84566635/RunnerMachine/README.md

# RunnerMachine
****
## RunnerMachine Project
* This prohject is for smart gyms!!! This project is running in a stc microcomputer platform includeing Relay,**WIFI** module **RFID reader** and so on.
## Function:
* This project can get the user's id infroamtion using the rfid model,and can get the data which is about runner machine like the speed, the height, the rate of heart and so on.
* This data will be transmit via the wifi interface which can be the received by the wifi router. We can use the rfid card info to manage users.
