84566635/RunnerMachine/跑步机项目资料集/RFID刷卡控制流程图v1.pdf

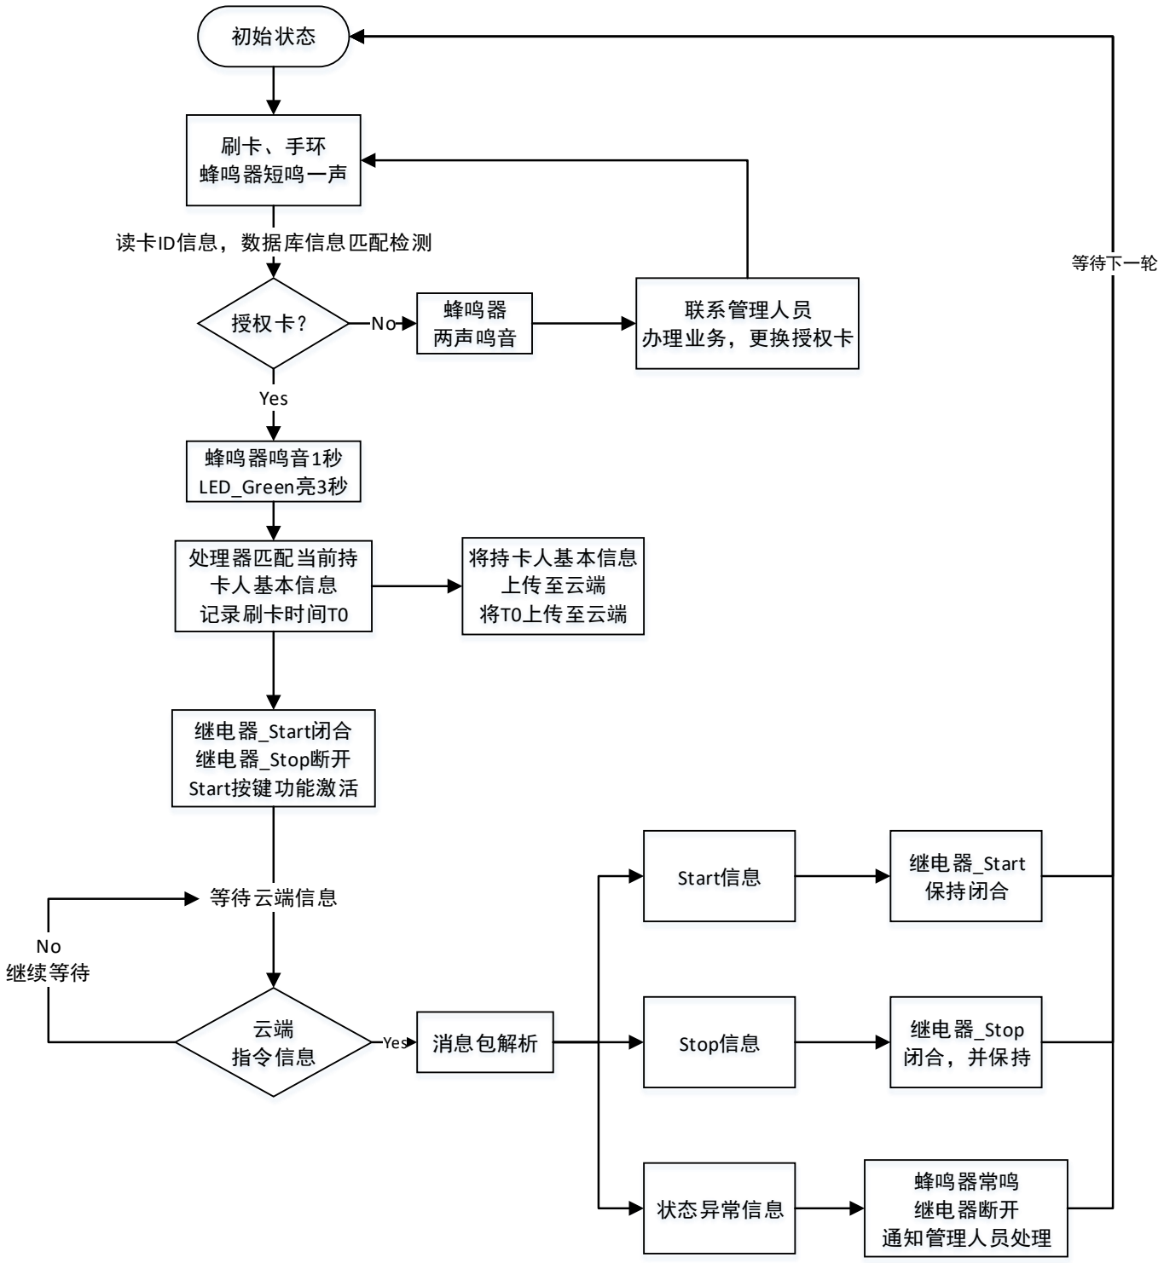
[picture p1: figure]
初始状态; 刷卡、手环 蜂鸣器短鸣一声; 读卡ID信息，数据库信息匹配检测; 授权卡？; 联系管理人员 办理业务，更换授权卡; Yes; 处理器匹配当前持 卡人基本信息 记录刷卡时间T0; 继电器_Start闭合 继电器_Stop断开 Start按键功能激活; 蜂鸣器 两声鸣音; 蜂鸣器鸣音1秒 LED_Green亮3秒; 云端 指令信息; 等待云端信息; No 继续等待; 消息包解析; 将持卡人基本信息 上传至云端 将T0上传至云端; Stop信息; Start信息; 状态异常信息; 继电器_Start 保持闭合; 继电器_Stop 闭合，并保持; 蜂鸣器常鸣 继电器断开 通知管理人员处理; 等待下一轮
