84566635/RunnerMachine/RFID_PCB/电路板/stc15xx-sch-pcb-library/stcmcu_Altium142_IntLib/Readme.txt

    本压缩包有3个文件，除了readme.txt文件以外，其余是altium的库文件，包含了stc公司的stc15系列所有单片机的电路图符号库和PCB的封装库。
库文件是用Altium designer 14.2.4版制作的，如果用低版本的altium软件，如protel 99, 请下载protel99版本并导入，或者请与STC公司联系获取技术支持。

需要特别注意的是：

		本库文件中的所有封装和元件都没有经过实际应用的验证，尽管有很多客户在用，而且目前也没有收到任何问题报告。但我们强烈建议客户自己再仔细校对一遍。
		STC公司从来没有用这个库文件设计电路图，也没有用它设计板子进行实际验证。
		如果客户因使用本文件而造成任何损失，STC公司不承担任何责任。

技术支持QQ：800003751
