84566635/RunnerMachine/RFIDIntegrated/V1.0/版本说明.txt

2018.01.05编写日志：
      这个版本旨在将RFID、E2PROM、串口功能集合在一起。
功能：
       1、RFID读ID卡号，并将读到的ID卡号串口打印；
       2、将读到的ID卡号写入E2PROM中，写入成功后，进行状态提示；
