84566635/RunnerMachine/跑步机项目资料集/WIFI模块设置参数.docx

网络名称：sports 加密方式：WPA2_AES 密钥:sports123 远端IP：192.168.0.10 端口9090

跑步机自东向西依次是1-16号

16 ip:192.168.0.116 mac:28:F3:66:43:5B:9B 9090

15 ip:192.168.0.115 mac:28:F3:66:44:5A:9E 9090

14 ip:192.168.0.114 mac:28:F3:66:44:59:C1 9090

13 ip:192.168.0.113 mac:40:D6:3C:04:05:2D 9090

12 ip:192.168.0.112 mac:28:F3:66:44:5B:39 9090

11 ip:192.168.0.111 mac:28:F3:66:44:5B:1F 9090

10 ip:192.168.0.110 mac:28:F3:66:44:59:D9 9090

9 ip:192.168.0.109 mac:28:F3:66:44:5A:2D 9090

8 ip:192.168.0.108 mac:28:F3:66:44:5A:90 9090

7 ip:192.168.0.107 mac:28:F3:66:05:87:E4 9090

6 ip:192.106.0.106 mac:28:F3:66:44:5A:8D 9090

5 ip:192.168.0.105 mac:28:F3:66:44:58:A4 9090

4 ip:192.168.0.104 mac:28:F3:66:44:5C:51 9090

3 ip:192.168.0.103 mac:28:F3:66:44:5A:6E 9090

2 ip:192.168.0.102 mac:28:F3:66:44:5B:97 9090

1 ip:192.168.0.101 mac:28:F3:66:44:5A:7C 9090
