84566635/RunnerMachine/跑步机项目资料集/跑步机上行数据协议.docx

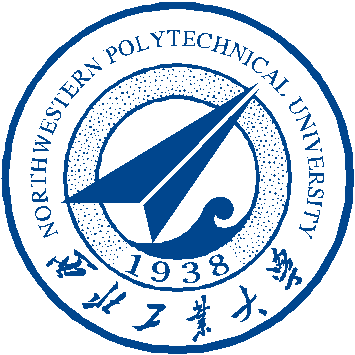
[picture p2: figure]
xb

健身房智能管理项目

资料集

西北工业大学新校区健身房

跑步机平台资料集

# 一、跑步机上行数据通讯协议

跑步机上行数据共计两种格式：

## 1、跑步机使用者的手环卡号信息：

含10字节，单帧发送，刷一次卡成功后，发送该数据，该数据包含：帧头+卡类型+卡ID号+帧尾，不含校验，采用16进制格式发送，波特率为115200，且此卡信息在刷卡成功匹配之后，发送一次。之后，当数据稳定之后，学生ID信息包含跑步机ID信息会以第六帧的形式重新发送，详见第六帧图表。ID信息数据格式具体如表1所示：

表1：使用者ID信息

帧头1 | 帧头2 | 命令3 | 卡类型 4-5 | | 卡号 6-9 | | | | 帧尾10
aaH | 55H | 06H | 44H | 00H | xxH | xxH | xxH | xxH | ccH

## 2、跑步机运行状态信息：

该运动状态信息包含6帧数据，共计120字节数据，每帧数据采用20个字节，未使用的字节数据填0，其中第一、第二帧数据传送跑步机设备编号（如图1所示），第三、第四、第五帧传送运动数据，第六帧传送学生ID信息和跑步机ID信息。采用16进制格式发送数据，波特率为115200，且发送周期为1s（平均），跑步机利用WIFI模块一次传送六帧数据，这六帧信息的详细情况如表二、，如下表2、3、4、5、6所示：

1） 第一帧,第二帧：传送设备编号

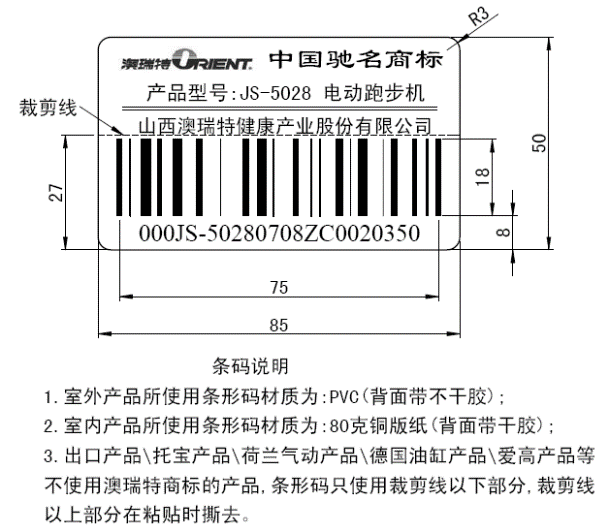
[picture p3: figure]

表2：传送设备编号（帧1,2）

帧头1 | 帧头2 | 命令3 | 第2个字节到第19个字节 | | | | | | | | | | | | | | | | 校验位
aaH | 55H | 01H | 0 | 0 | 0 | J | S | - | 5 | 0 | 2 | 8
aaH | 55H | 02H | 0 | 7 | 0 | 8 | Z | C | 0 | 0 | 2 | 0

图1 跑步机条码说明

2）第三帧、第四帧、第五帧：传送运动数据，运动数据在20字节中的长度如下表3、4、5所示，一个或者两个字节对应一个运动数据，具体长度由运动数据范围确定，比如体重0-150kg，一个字节足够，热量0-10000千卡就需要两个字节，不存在的参数数据用0填充。

表3：运动数据一（帧3）

帧头1 | 帧头2 | 命令3 | 4-19字节 | | | | | | | | | | | | | | | | 校验位
aaH | 55H | 03H | 时间（秒） | | 里程（米） | | 热量 （卡路里） | | 心率 | 转速 （RPM） | 速度 （X10） | | 坡度 N% | 档位 | 功率 （W） | | 力矩 （牛/米）
| | | 高位 | 低位 | 高位 | 低位 | 高 | 低 | | | 高 | 低 | | 1-30 | 高 | 低 | 高 | 低

表4：运动数据二（帧4）

帧头1 | 帧头2 | 命令3 | 4-19字节 | | | | | | | | | | | | | | | | 校验位
aaH | 55H | 04H | 模式 | 负荷 | | 频率 | 次数 | | 组数 | 目标 心率 | 最大肌力 （公斤） | | 最大摄氧量
| | | 1-30 | 高 | 低 | 0-255 | 高 | 低 | | | 高 | 低 | 高 | 低

表5：运动数据三（帧5）

帧头1 | 帧头2 | 命令3 | 备用帧4-19字节 | | | | | | | | | | | | | | | | 校验位
aaH | 55H | 05H

注：

（1）接收数据300，实际速度30。速度有小数点；

（2）坡度同速度，最大155(15.5%)；

（3）负荷也有小数点；

（4）最大摄氧量有小数点；

（5）校验方式：自包括第1位（帧头）到第18位外加两个字节秘钥的按位异或，秘钥暂定为0XE1，0XE2。

3）第六帧：传送学生ID信息和跑步机ID信息，共计20字节数据，其中学生ID信息位于第6-第9位，共计4byte，学生ID信息同跑步机ID信息中间以2byte的字符“cc cc”分割，跑步机ID号信息为第12-第18位共计7byte，其中以16进制形式表示，详见第三节跑步机ID表；帧尾为“ff ff”，共计2byte，详情请看下表6：

表6：ID信息（帧6）

帧头1 | 帧头2 | 命令3 | 卡ID信息(第4-9) | | | | | | 第10-11字节 | | 跑步机ID(第12-18字节) | | | | | | | 19-20字节
aaH | 55H | 06H | 卡类型 | | 卡ID号 | | | | 分隔符 | | 跑步机ID | | | | | | | 帧尾
| | | 44 | 00 | | | | | cc | cc | | | | | | | | ff | ff

# 二、跑步机WIFI接口设置

## 1、路由器无线网络接口：

网络名称：sports；

加密方式：WPA2_AES；

密钥：sports123

## 2、服务器接口设置：

（远端）IP：192.168.0.10

端口：9090

## 3、跑步机WIFI接口：

### 1）接口配置：

工作模式：STA Manual；

网络协议：TCP客户端；

无线参数：需同路由器设置一致；

本地端口：9090；

网络参数：

未启用DHCP；

本地IP：如表1所示：

子网掩码：255.255.255.0；

网关：192.168.0.1；

DNS：192.168.0.1。

串口参数：

波特率：115200；

数据为8位；

检验位：无；

停止位：1位。

### 2）16台跑步机IP地址:

表1：16台跑步机WIFI接口信息

| 编号 | IP地址 | MAC地址 | 端口
东 <-------------------------------> 西 | 16 | 192.168.0.116 | 28:F3:66:43:5B:9B | 9090
| 15 | 192.168.0.115 | 28:F3:66:44:5A:9E | 9090
| 14 | 192.168.0.114 | 28:F3:66:44:59:C1 | 9090
| 13 | 192.168.0.113 | 40:D6:3C:04:05:2D | 9090
| 12 | 192.168.0.112 | 28:F3:66:44:5B:39 | 9090
| 11 | 192.168.0.111 | 28:F3:66:44:5B:1F | 9090
| 10 | 192.168.0.110 | 28:F3:66:44:59:D9 | 9090
| 9 | 192.168.0.109 | 28:F3:66:44:5A:2D | 9090
| 8 | 192.168.0.108 | 28:F3:66:44:5A:90 | 9090
| 7 | 192.168.0.107 | 28:F3:66:05:87:E4 | 9090
| 6 | 192.168.0.106 | 28:F3:66:44:5A:8D | 9090
| 5 | 192.168.0.105 | 28:F3:66:44:58:A4 | 9090
| 4 | 192.168.0.104 | 28:F3:66:44:5C:51 | 9090
| 3 | 192.168.0.103 | 28:F3:66:44:5A:6E | 9090
| 2 | 192.168.0.102 | 28:F3:66:44:5B:97 | 9090
| 1 | 192.168.0.101 | 28:F3:66:44:5A:7C | 9090

# 三、跑步机ID号

表1：16台跑步机ID信息(16进制)

| 跑步机号 | 跑步机ID号(hex)
东 <-------------------------------> 西 | 01 | f628838e1d3600
| 02 | f62883881d30dd
| 03 | f628837f1d2399
| 04 | f62883811d2977
| 05 | f62883a31e4d20
| 06 | f628837a1d1937
| 07 | f62883ae1e58b2
| 08 | f628837a1d1935
| 09 | f62883881d30da
| 10 | f62883a31e4d1e
| 11 | f628837f1d2351
| 12 | f62883cc1f7378
| 13 | f62883b71e5a1e
| 14 | f628837f1d239c
| 15 | f62883971d3783
| 16 | f62883cc1f733d

# 四、手环ID表

共计300个手环，下表为该300个手环的10位ID和8位ID（16进制，程序中使用）

编号 | 10位ID号 | 8位ID号 | | 编号 | 10位ID号 | 8位ID号 | | 编号 | 10位ID号 | 8位ID号
1 | 2317825796 | 0x8A273704 | | 101 | 2318391812 | 0x8A2FDA04 | | 201 | 2318225412 | 0x8A2D5004
2 | 2319273988 | 0x8A3D5004 | | 102 | 2318166532 | 0x8A2C6A04 | | 202 | 2318376452 | 0x8A2F9E04
3 | 2318366724 | 0x8A2F7804 | | 103 | 2318234628 | 0x8A2D7404 | | 203 | 2317765124 | 0x8A264A04
4 | 2317816580 | 0x8A271304 | | 104 | 2318298116 | 0x8A2E6C04 | | 204 | 2318244868 | 0x8A2D9C04
5 | 2318172164 | 0x8A2C8004 | | 105 | 2319257348 | 0x8A3D0F04 | | 205 | 2319354884 | 0x8A3E8C04
6 | 2319336964 | 0x8A3E4604 | | 106 | 2318102020 | 0x8A2B6E04 | | 206 | 2318246148 | 0x8A2DA104
7 | 2318117892 | 0x8A2BAC04 | | 107 | 2318356228 | 0x8A2F4F04 | | 207 | 2319302404 | 0x8A3DBF04
8 | 2318233860 | 0x8A2D7104 | | 108 | 2317758980 | 0x8A263204 | | 208 | 2318387972 | 0x8A2FCB04
9 | 2319296516 | 0x8A3DA804 | | 109 | 2318230788 | 0x8A2D6504 | | 209 | 2318116100 | 0x8A2BA504
10 | 2319282180 | 0x8A3D7004 | | 110 | 2317825540 | 0x8A273604 | | 210 | 2318287364 | 0x8A2E4204
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
98 | 2319409156 | 0x8A3F6004 | | 198 | 2318385156 | 0x8A2FC004 | | 298 | 2318290948 | 0x8A2E5004
99 | 2317860100 | 0x8A27BD04 | | 199 | 2317764356 | 0x8A264704 | | 299 | 2318364164 | 0x8A2F6E04
100 | 2318371844 | 0x8A2F8C04 | | 200 | 2317817860 | 0x8A271804 | | 300 | 2318106884 | 0x8A2B8104
