84566635/RunnerMachine/跑步机项目资料集/刷卡流程V2.pdf

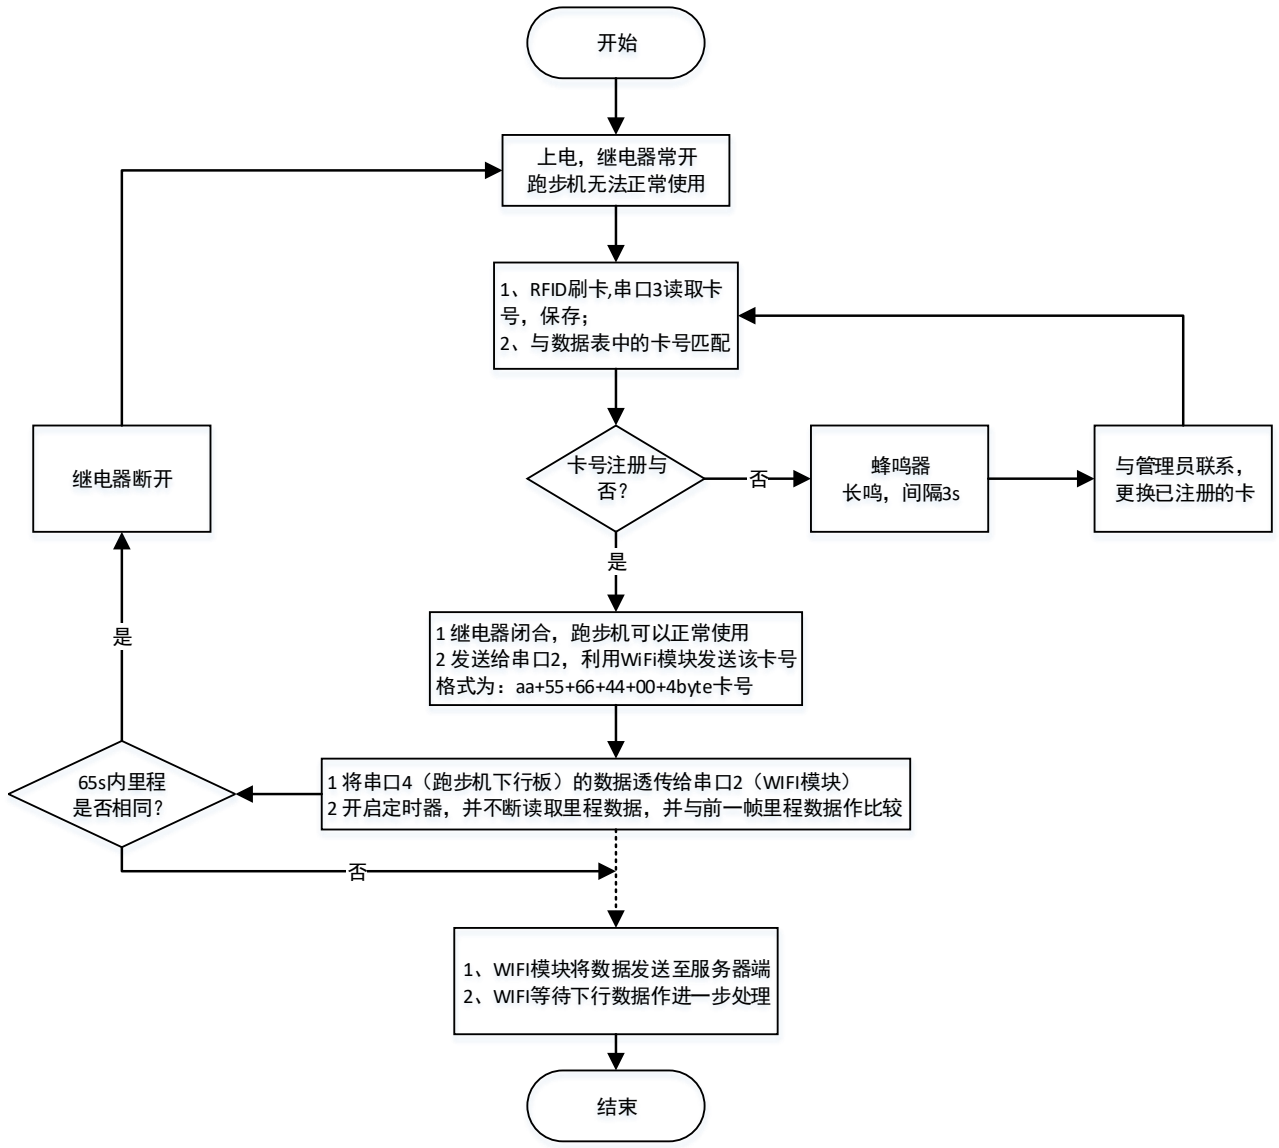
[picture p4: figure]
上电，继电器常开 跑步机无法正常使用; 1、RFID刷卡,串口3读取卡 号，保存； 2、与数据表中的卡号匹配; 卡号注册与 否？; 蜂鸣器 长鸣，间隔3s; 1 继电器闭合，跑步机可以正常使用 2 发送给串口2，利用WiFi模块发送该卡号 格式为：aa+55+66+44+00+4byte卡号; 与管理员联系， 更换已注册的卡; 1 将串口4（跑步机下行板）的数据透传给串口2（WIFI模块） 2 开启定时器，并不断读取里程数据，并与前一帧里程数据作比较; 65s内里程 是否相同？; 继电器断开; 1、WIFI模块将数据发送至服务器端 2、WIFI等待下行数据作进一步处理
