84566635/RunnerMachine/跑步机项目资料集/跑步机项目系统框图.png

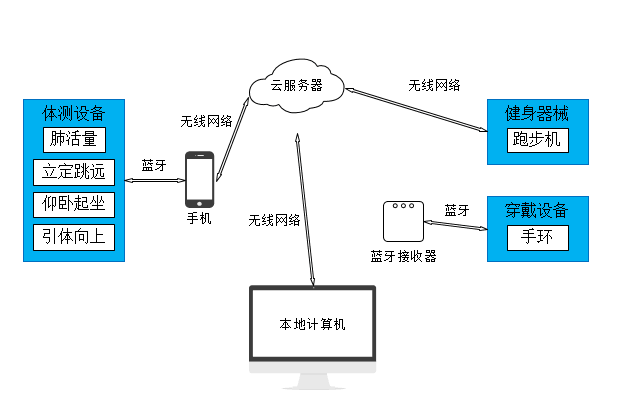
跑步机项目资料集/跑步机项目系统框图.png
