84566635/RunnerMachine/RFID_PCB/电路板/StartV2/跑步机start/StartV2元器件清单.pdf

Bill of Materials | Bill of Materials For PCB Document [StartV2.PcbDoc]
Source Data From: | StartV2.PcbDoc
Project: | | PCB_Project1.PrjPCB
Variant: | | None
Creation Date: 2018/1/22 | 10:21:49
Print Date: | 43122 | 43122.43234
Footprint | Comment | LibRef | Designator | Description | Quantity
BEEP | BEEP | BEEP | BEEP2 | 1
CAP | 104 | CAP | C1, C4, C11 | 3
capc | 10uF | CAPC | C2 | 1
CAP | 105 | CAP | C3, C5 | 2
CAP | 223 | CAP | C6 | 1
CapE | 104 | CapE | C7, C8, C9, C10 | 4
DB9 | RS232 | RS232 | COMP | 1
ConTerminal | ConTerminal | ConTerminal | CT1, CT2, CT3 | 3
D4148_1206 | D4148 | D4148_1206 | D1, D2 | 2
LED_3mm | LED_3mm | LED_3mm | LED1, LED2, LED3, LED4 | 4
mUSB | mUSB | mUSB | mUSB1 | 1
pin4 | pin4 | pin4 | P1 | 1
pin5 | pin5 | pin5 | P2, P3 | 2
pin8 | pin8 | pin8 | P4 | 1
WiFi | WiFi | WiFi | P5 | 1
res | 200 | RES | R1 | 1
res | 1k | RES | R2 | 1
res | 4.7k | RES | R3, R6 | 2
res | 100 | RES | R4, R7 | 2
继电器-SRD | 继电器-Stop | 继电器-SRD | Relay2 | 1
继电器-SRD | 继电器-Start | 继电器-SRD | Rely1 | 1
Horizontal_S
witch

Horizontal_Swit
ch

Horizontal_Swit
ch
S1 | 1
PNP | 8550 | PNP | T1, T2 | 2
STC8A8K64
S4A12_LQF
P64S

STC8A8K64S4A
12_LQFP64

STC8A8K64S4A
12_LQFP64
U2 | 1
RT9193-33 | RT9193-33 | RT9193-33 | U3 | 1
MAX232 | MAX232 | MAX232 | U4 | 1
| | | | 42
Approved | | Notes
