84566635/RunnerMachine/跑步机项目资料集/StartV2.PDF

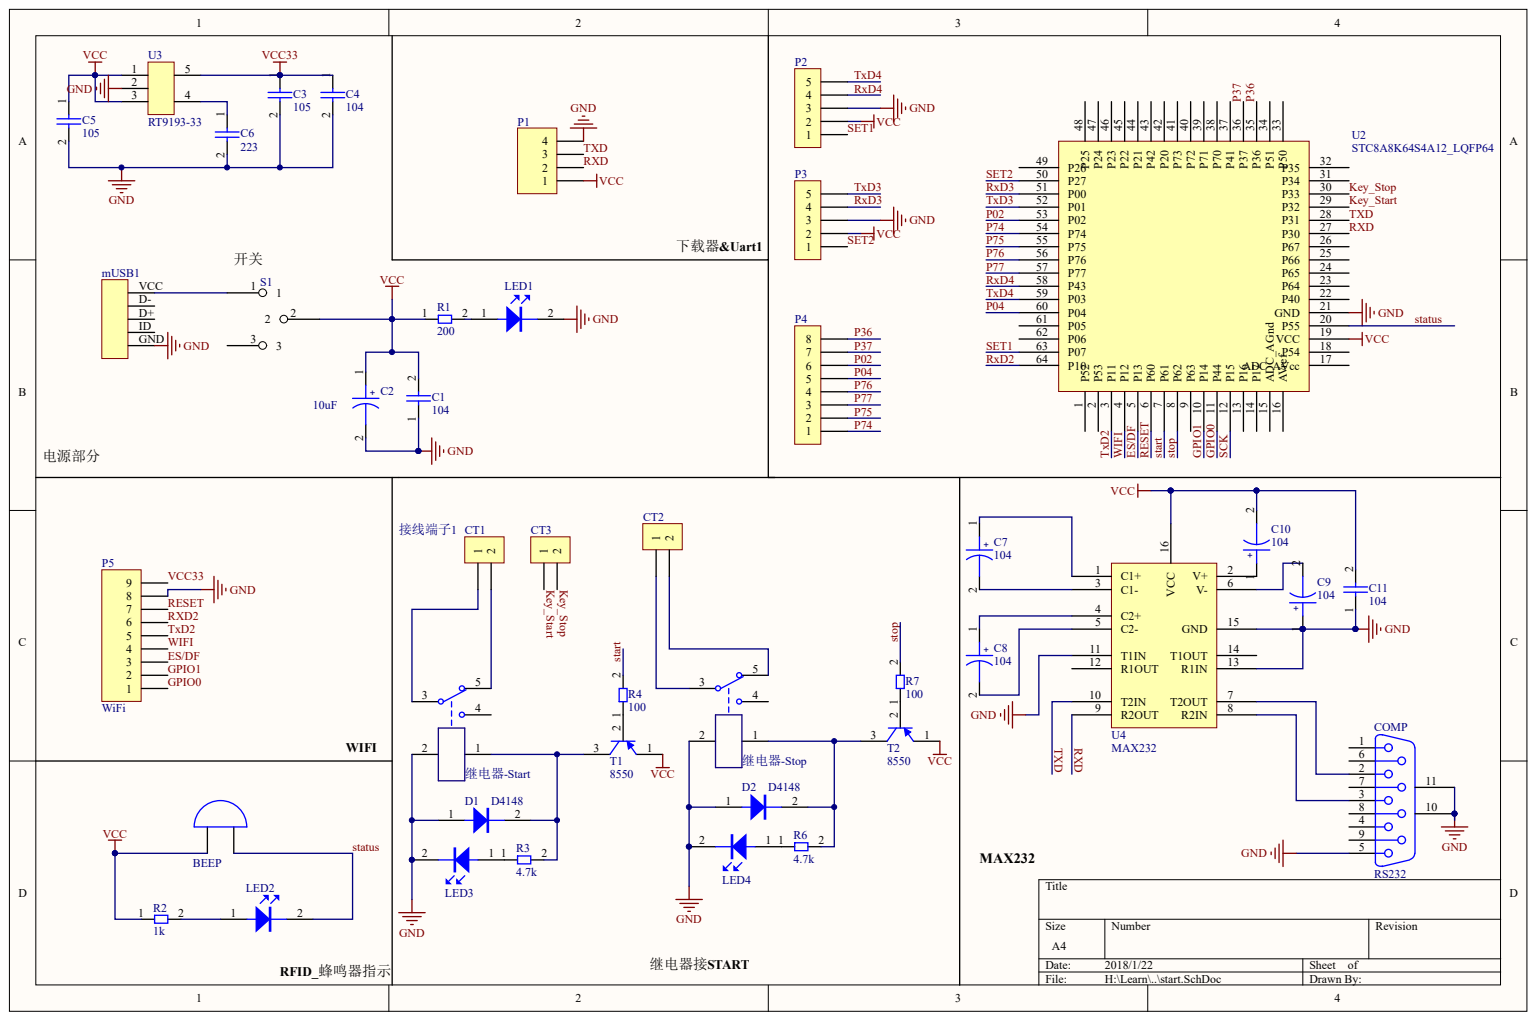
[picture p6: page 1]

GND | 2 | 4 | C3

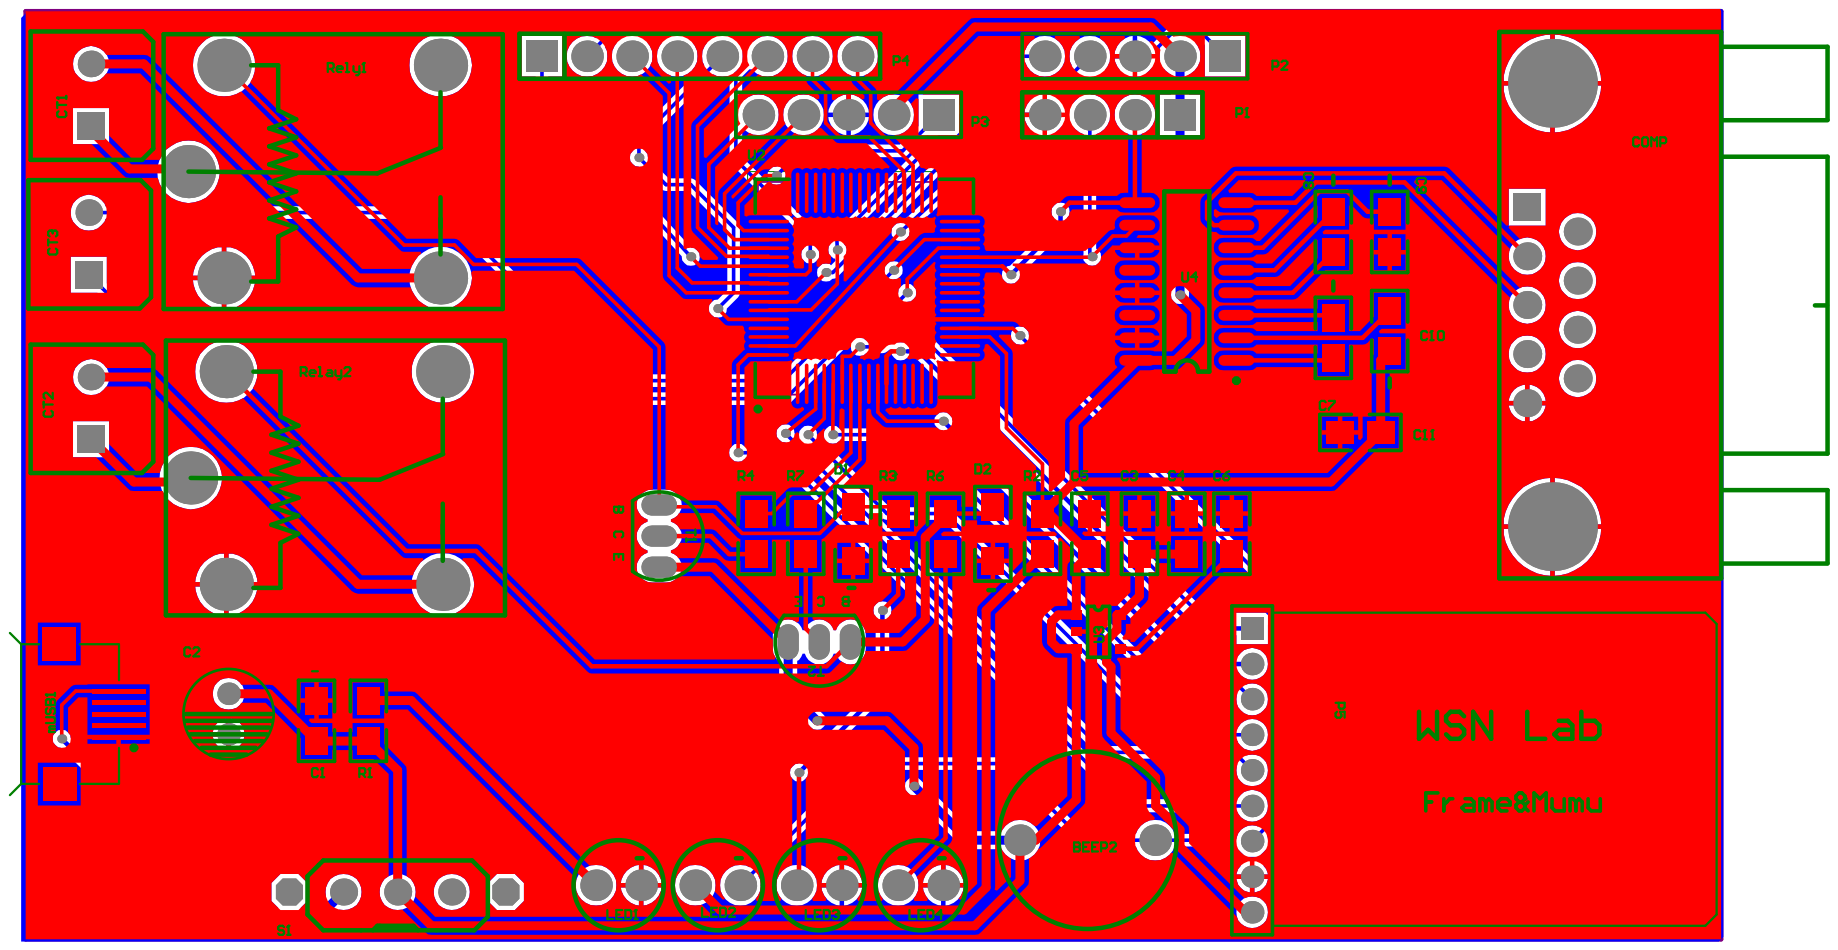
[picture p7: page 2]
