84566635/RunnerMachine/跑步机项目资料集/跑步机项目v2.0板接线图.pdf

# Vcc

# GND

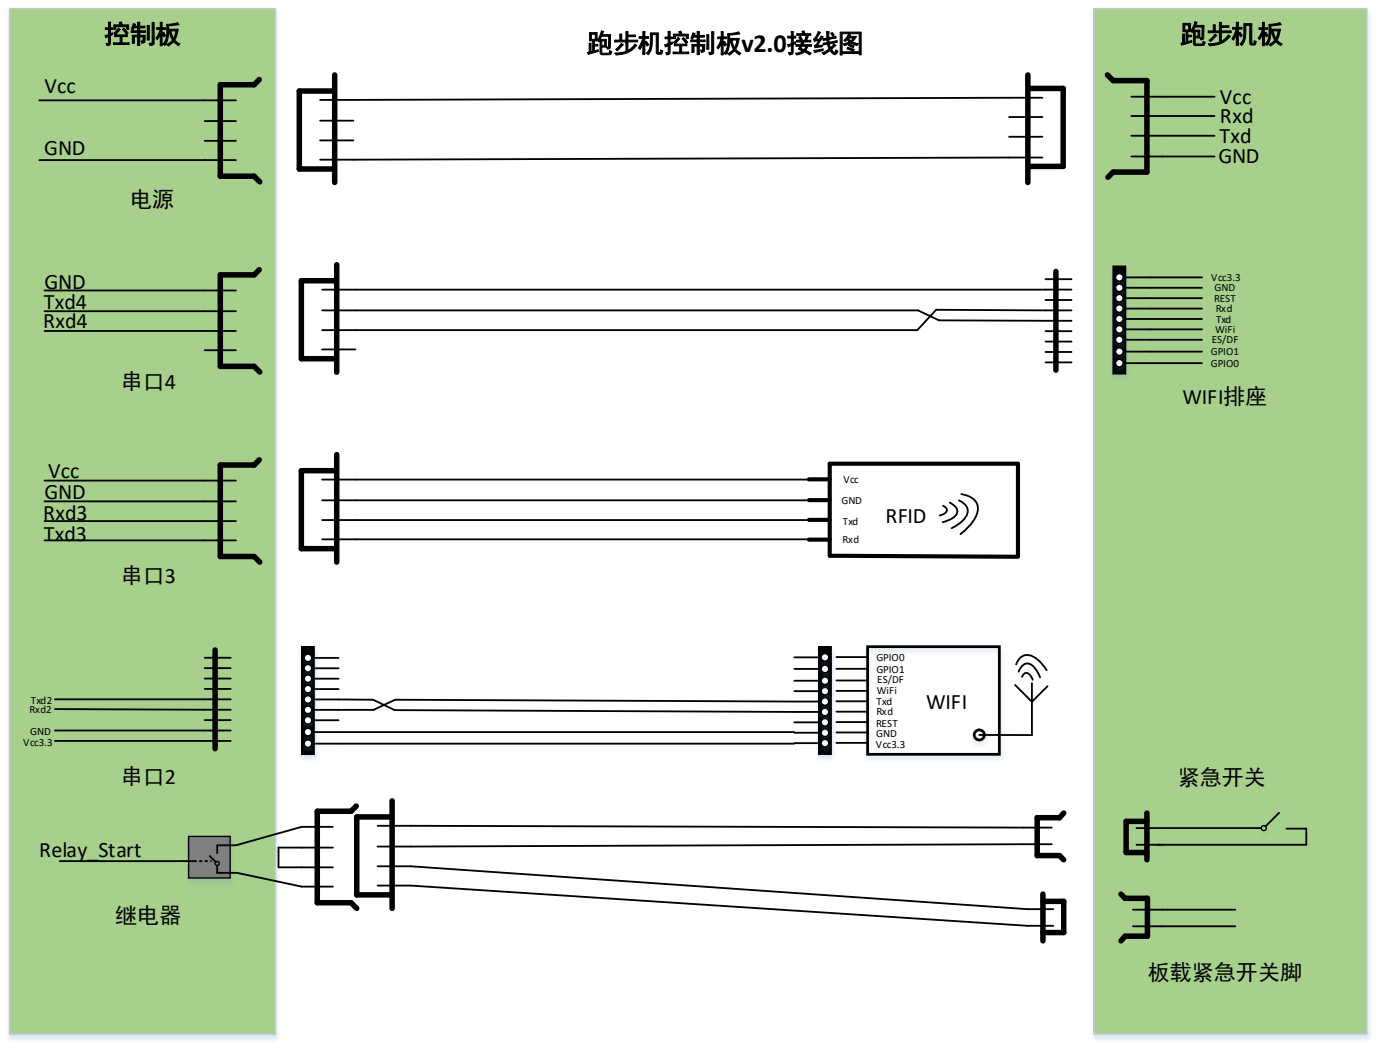
[picture p8: page 1]
Vcc Rxd Txd GND; Vcc3.3 GND REST Rxd Txd WiFi ES/DF GPIO1 GPIO0; GND Txd4 Rxd4; Vcc GND Rxd3 Txd3; RFID; Vcc; GND; Txd; Rxd; Vcc3.3; Rxd2; Txd2; REST; WiFi; GPIO1; GPIO0; WIFI; Relay_Start; 紧急开关; 板载紧急开关脚; 继电器; WIFI排座; 控制板; 跑步机控制板v2.0接线图; 跑步机板
