84566635/RunnerMachine/RFID_PCB/电路板/StartV2/跑步机start/start.PDF

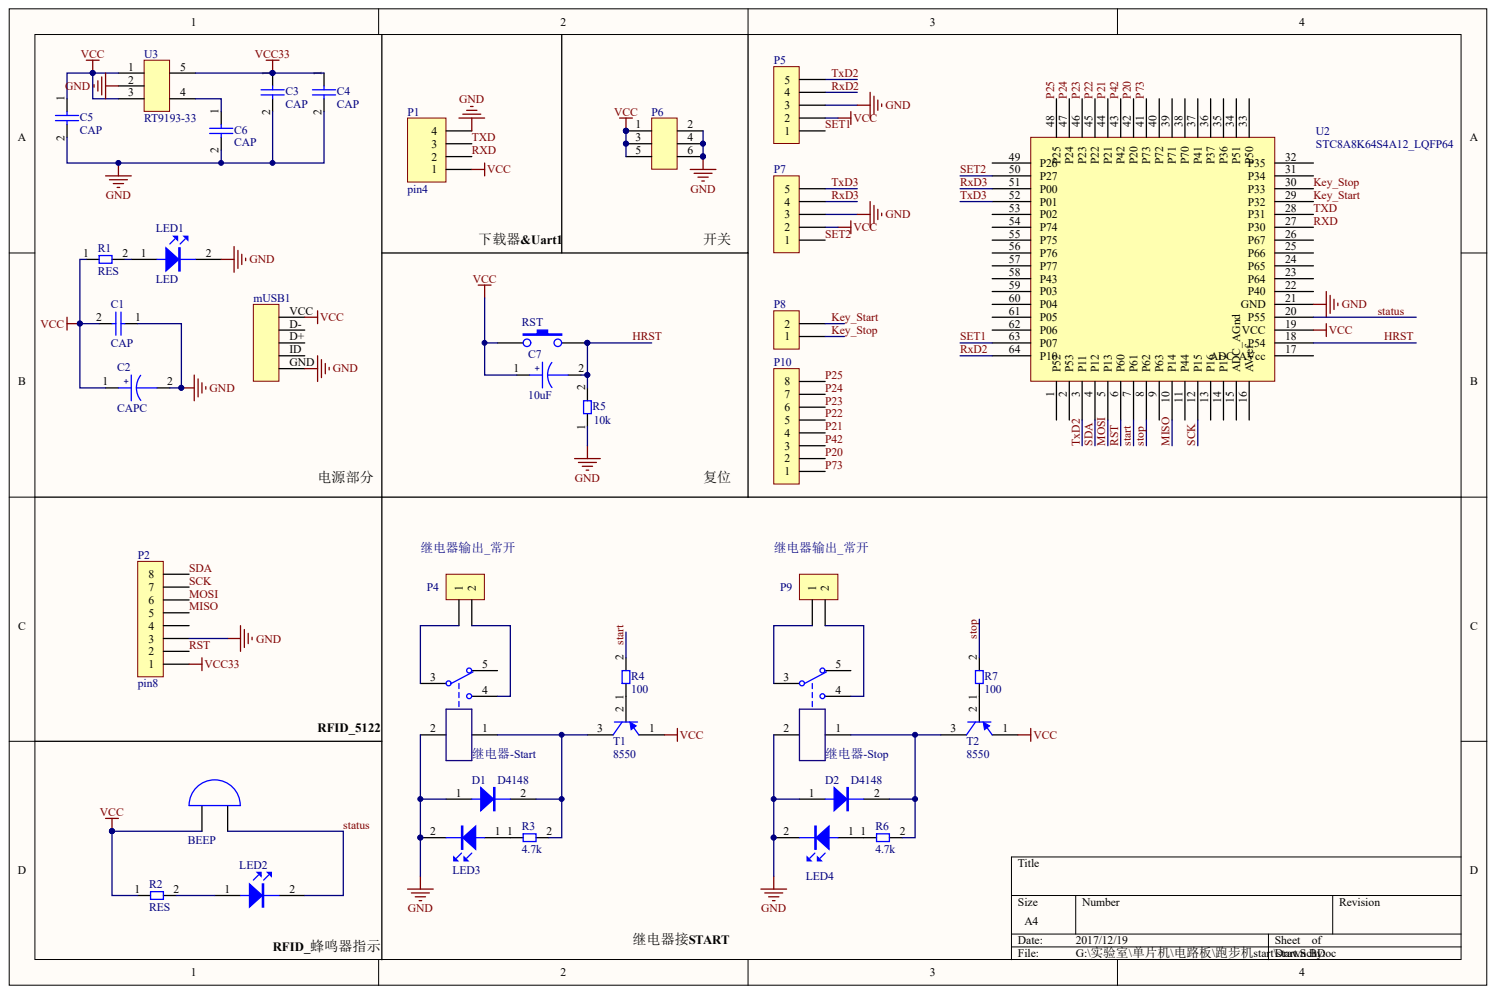
[picture p9: page 1]

GND | 2 | 4 | C3

GND P1 下载器&Uart1 | VCC P6 开关

CAP C6
