84566635/RunnerMachine/RFID_PCB/电路板/StartV2/跑步机start/StartV3.0.PDF

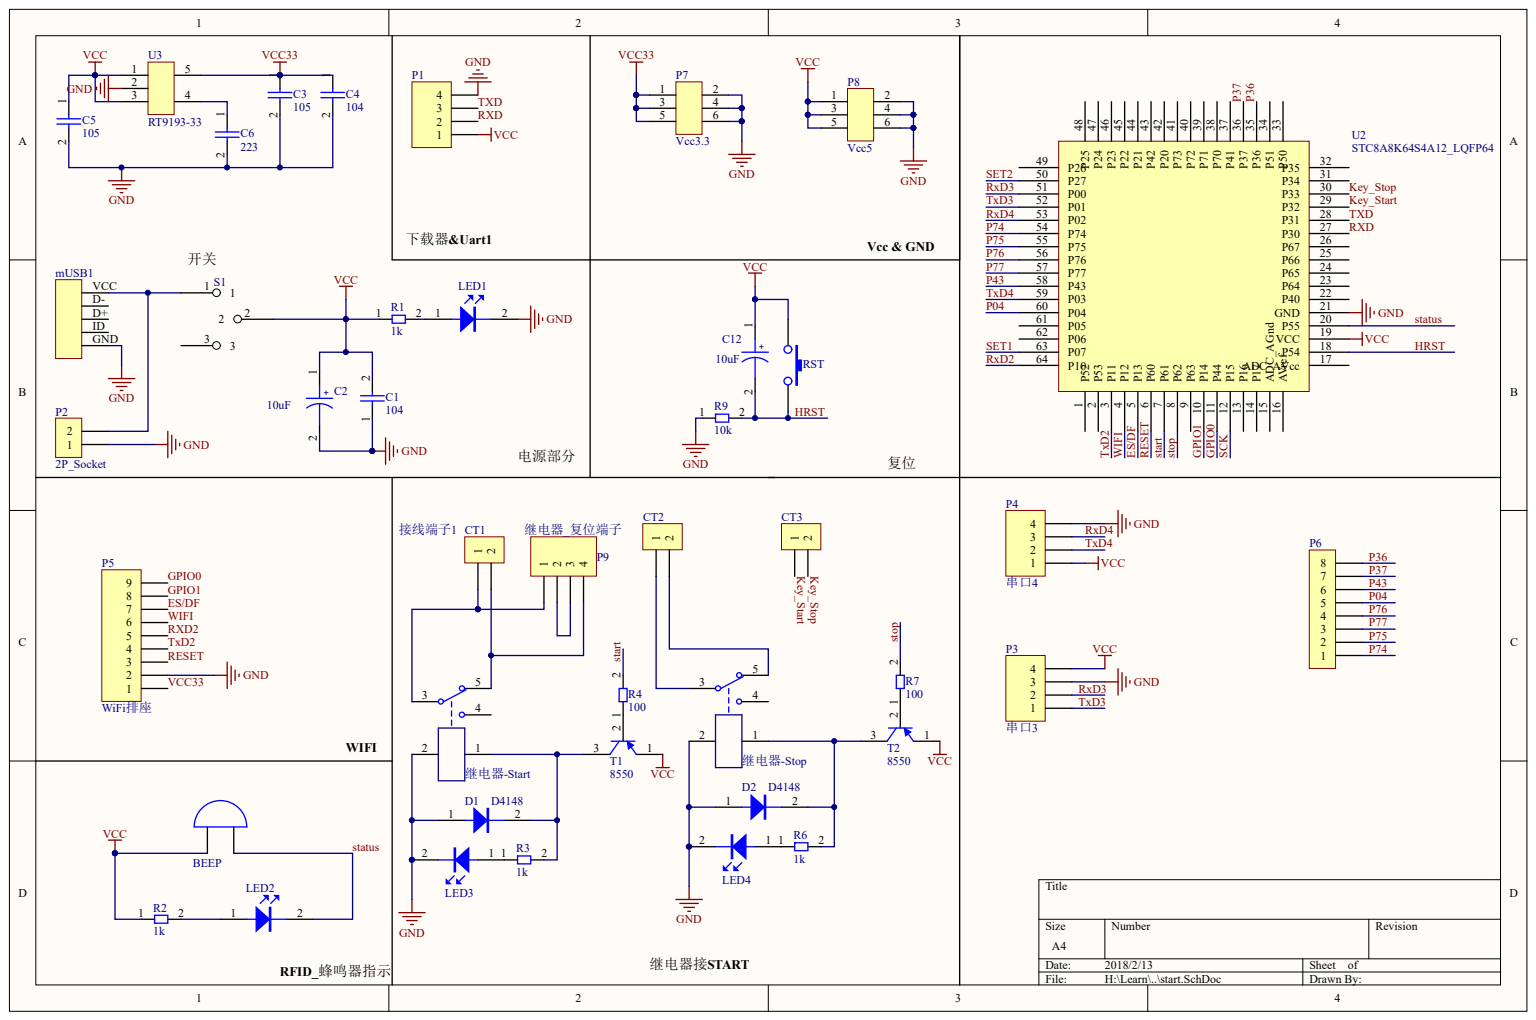
[picture p10: page 1]

GND | 2 | 4 | C3

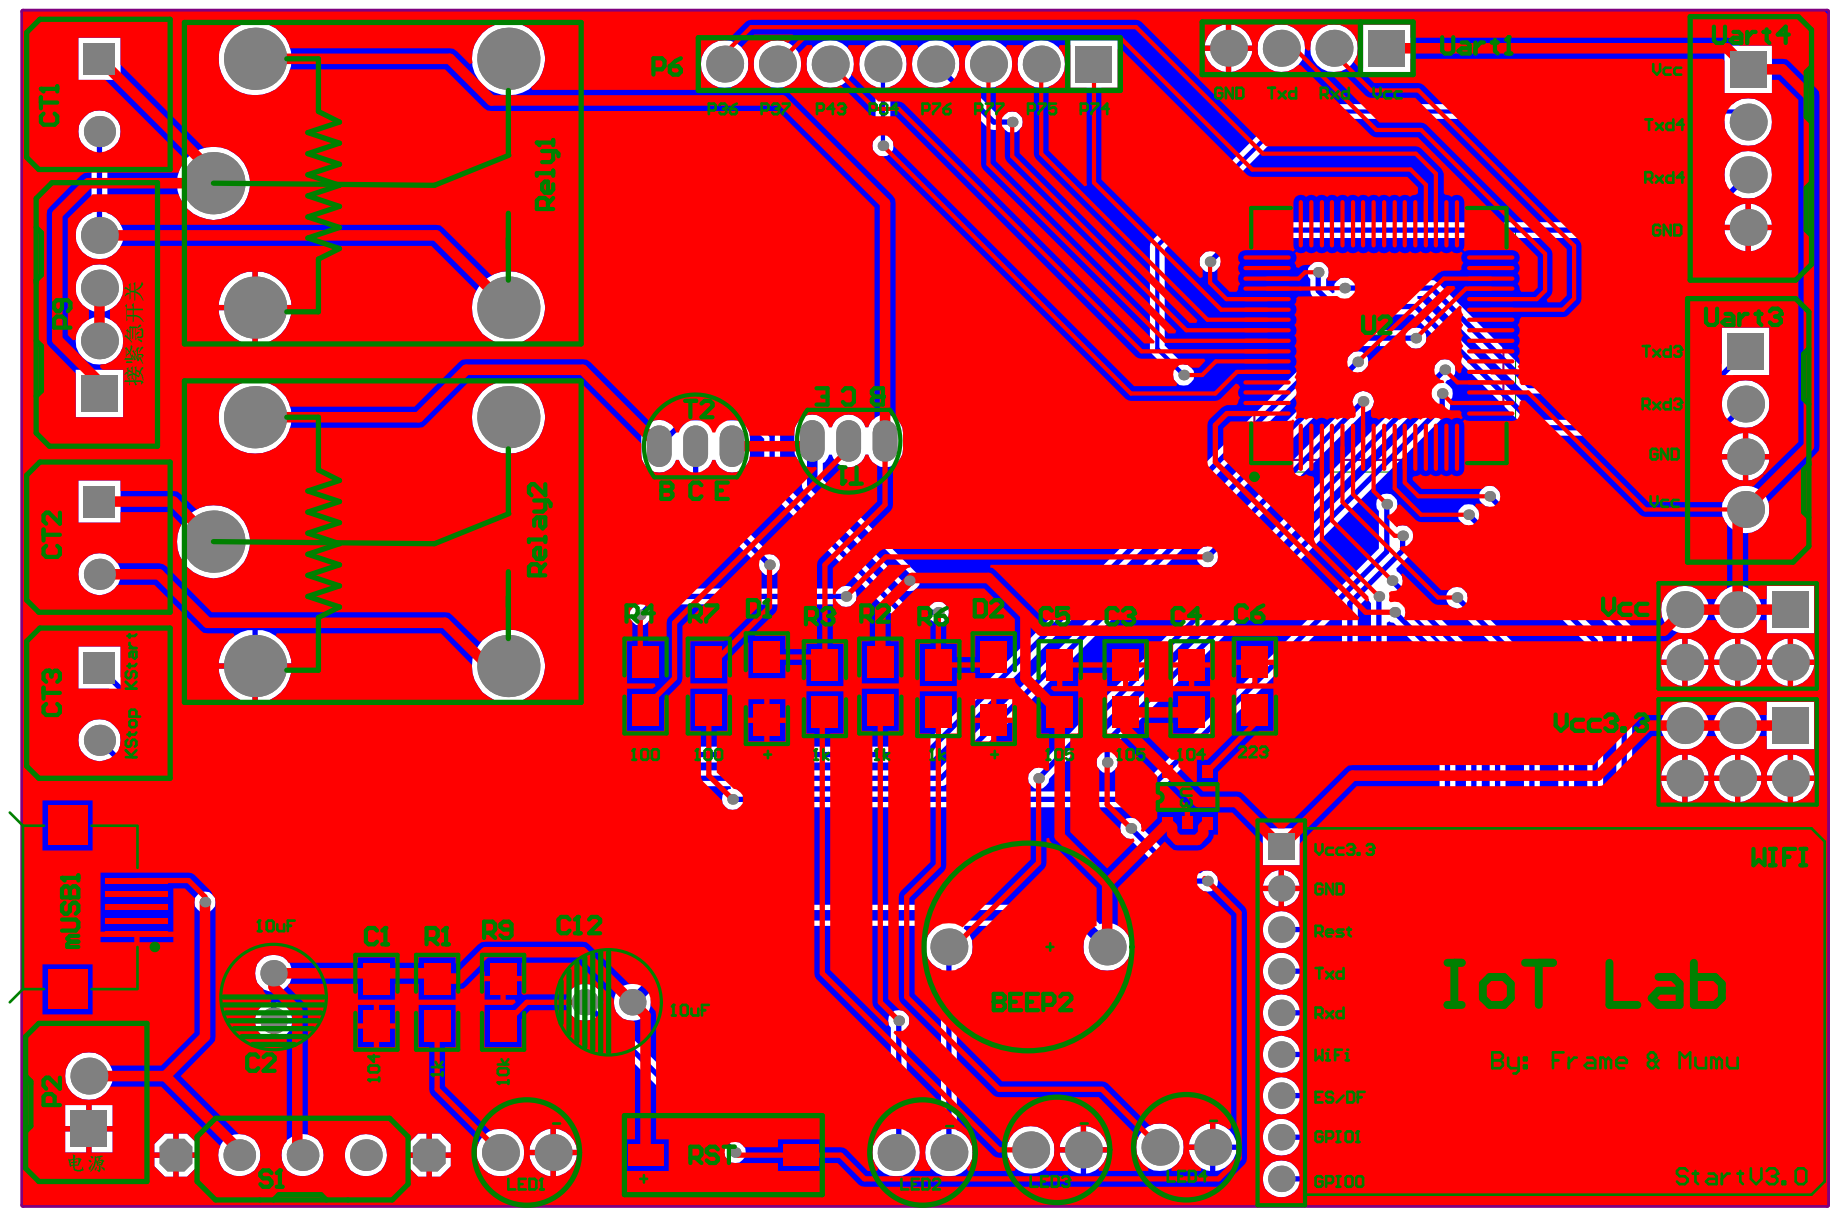
[picture p11: page 2]

Bill of Materials | <Parameter Title not found>
Source Data From: | PCB_Project1.PrjPCB
Project: | | PCB_Project1.PrjPCB
Variant: | | None
Creation Date: 2018/2/13 | 16:13:19
Print Date: | 43144 | 43144.67651
Footprint | Comment | LibRef | Designator | Description | Quantity
BEEP | BEEP | BEEP | BEEP2 | 1
CAP | 104 | CAP | C1, C4 | 2
capc | 10uF | CAPC | C2, C12 | 2
CAP | 105 | CAP | C3, C5 | 2
CAP | 223 | CAP | C6 | 1
ConTerminal | ConTerminal | ConTerminal | CT1, CT2, CT3 | 3
D4148_1206 | D4148 | D4148_1206 | D1, D2 | 2
LED_3mm | LED_3mm | LED_3mm | LED1, LED2, LED3, LED4 | 4
mUSB | mUSB | mUSB | mUSB1 | 1
pin4 | pin4 | pin4 | P1 | 1
2P_Socket | 2P_Socket | 2P_Socket | P2 | 1
4P_Socket | 串口3 | 4P_Socket | P3 | 1
4P_Socket | 串口4 | 4P_Socket | P4 | 1
WiFi | WiFi排座 | WiFi | P5 | 1
pin8 | pin8 | pin8 | P6 | 1
pin6 | Vcc3.3 | pin6 | P7 | 1
pin6 | Vcc5 | pin6 | P8 | 1
4P_Socket | 继电器_复位端
子
4P_Socket | P9 | 1
res | 1k | RES | R1, R2, R3, R6 | 4
res | 100 | RES | R4, R7 | 2
res | 10k | RES | R9 | 1
继电器-SRD | 继电器-Stop | 继电器-SRD | Relay2 | 1
继电器-SRD | 继电器-Start | 继电器-SRD | Rely1 | 1
SW_PB | SW_PB | SW_PB | RST | 1
Horizontal_S witch | Horizontal_Swit ch | Horizontal_Swit ch
S1 | 1
PNP | 8550 | PNP | T1, T2 | 2
STC8A8K64 S4A12_LQF P64S | STC8A8K64S4A 12_LQFP64 | STC8A8K64S4A 12_LQFP64
U2 | 1
RT9193-33 | RT9193-33 | RT9193-33 | U3 | 1
| | | | 42
Approved | | Notes
