84566635/RunnerMachine/RFID_PCB/电路板/StartV2/跑步机start/StartV2电路板图.PDF

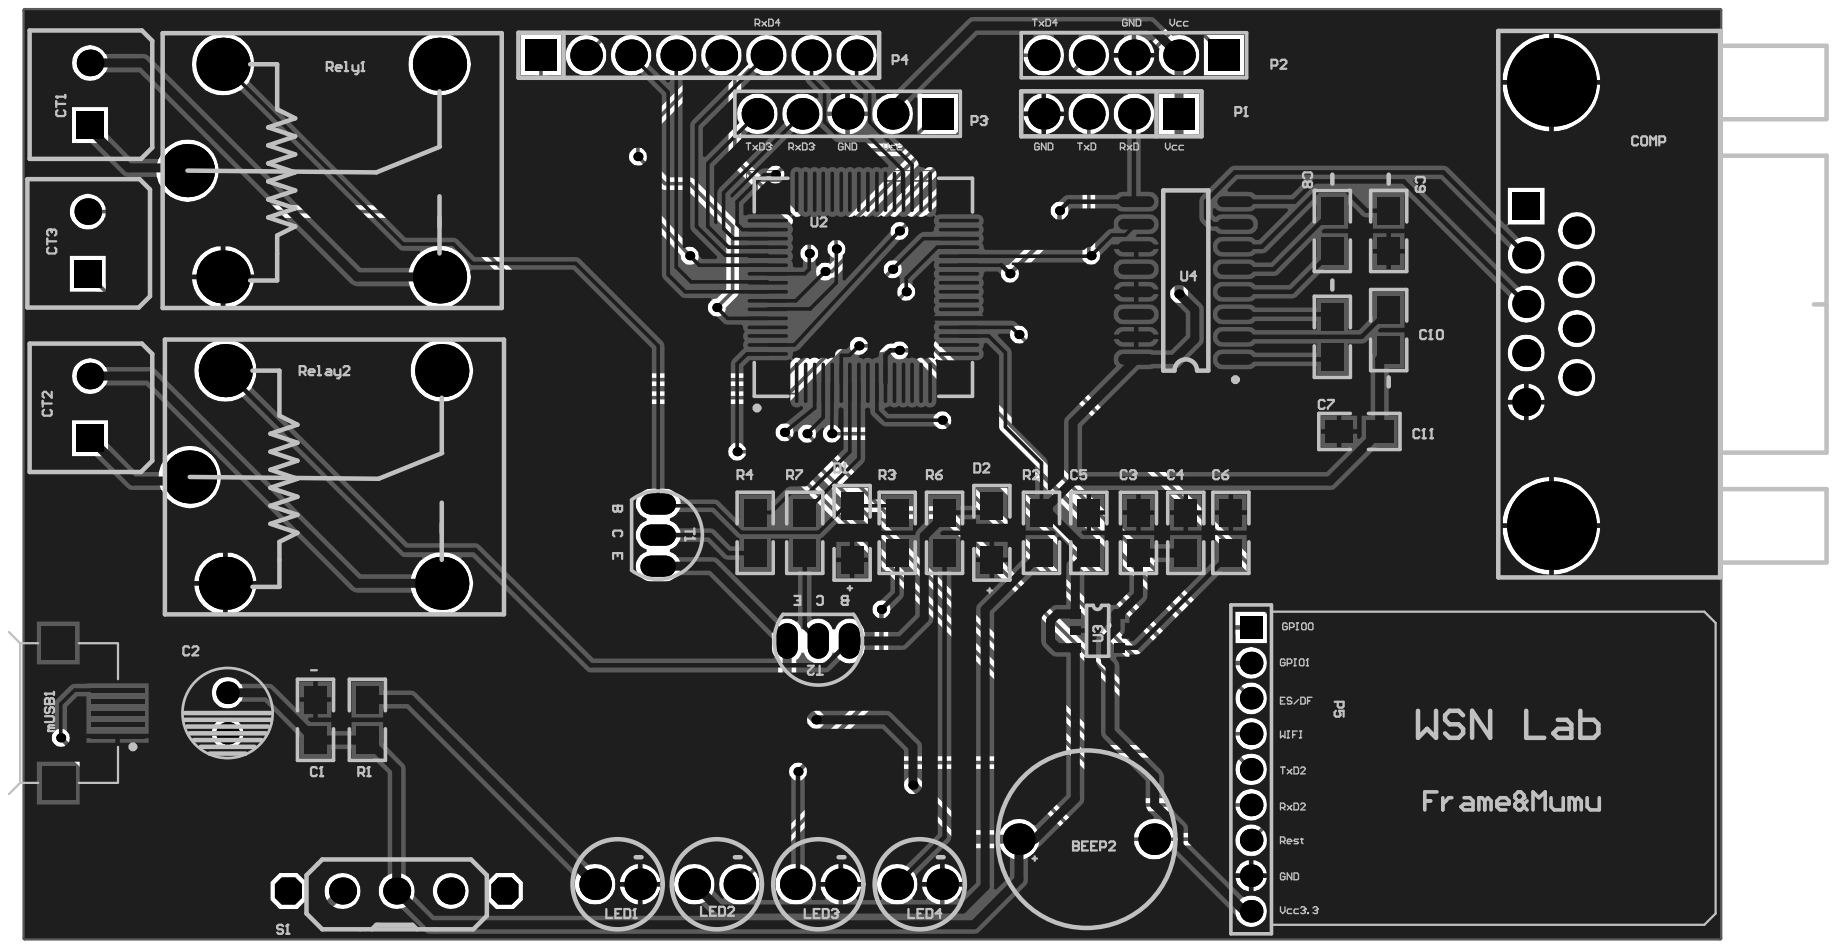
[picture p12: page 1]
