84566635/RunnerMachine/(list of files, drawings)

Other design files:
RFID_PCB/电路板/new/PCB库a.PcbLib
RFID_PCB/电路板/new/原理图库a.SchLib
RFID_PCB/电路板/PcbLib-LQFP64.PcbLib
RFID_PCB/电路板/PCB库.PcbLib
RFID_PCB/电路板/StartV2/跑步机start/PCB_Project1.PrjPCB
RFID_PCB/电路板/StartV2/跑步机start/start.PcbDoc
RFID_PCB/电路板/StartV2/跑步机start/start.SchDoc
RFID_PCB/电路板/StartV2/跑步机start/StartV2.PcbDoc
RFID_PCB/电路板/原理图库.SchLib
