84566635/RunnerMachine/RFIDIntegrated/RFIDFinalv1.0/fun.c

#include <fun.h>

#define ID_NUM 301
// uchar CardType[2] = {0x00, 0x0};
// uchar UID[4] = {0x00, 0x00, 0x00, 0x00};
uchar xdata g_ucTempbuf[20];
const uchar xdata UIDlist[ID_NUM][4] = {
{0x8A,0x27,0x37,0x04},
{0x8A,0x3D,0x50,0x04},
{0x8A,0x2F,0x78,0x04},
{0x8A,0x27,0x13,0x04},
{0x8A,0x2C,0x80,0x04},
{0x8A,0x3E,0x46,0x04},
{0x8A,0x2B,0xAC,0x04},
{0x8A,0x2D,0x71,0x04},
{0x8A,0x3D,0xA8,0x04},
{0x8A,0x3D,0x70,0x04},
{0x8A,0x3E,0x6A,0x04},
{0x8A,0x2B,0xB8,0x04},
{0x8A,0x2C,0x45,0x04},
{0x8A,0x2D,0x8D,0x04},
{0x8A,0x2D,0x43,0x04},
{0x8A,0x27,0x26,0x04},
{0x8A,0x2C,0x5C,0x04},
{0x8A,0x27,0x3D,0x04},
{0x8A,0x2F,0x5E,0x04},
{0x8A,0x27,0xDB,0x04},
{0x8A,0x3D,0xD3,0x04},
{0x8A,0x2F,0xBB,0x04},
{0x8A,0x3D,0xE2,0x04},
{0x8A,0x2F,0xAA,0x04},
{0x8A,0x3E,0x4D,0x04},
{0x8A,0x2C,0x4D,0x04},
{0x8A,0x2F,0x49,0x04},
{0x8A,0x2B,0xA9,0x04},
{0x8A,0x2D,0xBE,0x04},
{0x8A,0x27,0xF0,0x04},
{0x8A,0x2E,0x57,0x04},
{0x8A,0x3D,0xCC,0x04},
{0x8A,0x3D,0x0D,0x04},
{0x8A,0x27,0xC3,0x04},
{0x8A,0x2D,0x84,0x04},
{0x8A,0x26,0x4F,0x04},
{0x8A,0x3D,0x12,0x04},
{0x8A,0x3E,0x62,0x04},
{0x8A,0x3D,0x78,0x04},
{0x8A,0x3D,0xED,0x04},
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
};

/**延时 n ms
 * n：n ms
 */ 
void delay1(uint n)
{
    uchar i, j;
    while (n--) {
        i = 15;
        j = 90;
        do
        {
            while (--j);
        } while (--i);
    }
}
/**寻找指定UID的卡号
 * UID：需要匹配的卡号
 */
bit FindUID(char *UID)
{
    char* UID_Temp = UID;
	uchar xdata i,k;
    for (i = 0; i < ID_NUM; i ++)
    {
        UID_Temp = UID;
		for (k = 0; k < 4;k ++)
        {
            if ((*UID_Temp++) != UIDlist[i][k])
            {
				break;
            }
			return 1;
       }
    }
    return 0;
}
