84566635/RunnerMachine/RFIDIntegrated/V1.0/MFRC522.h

#ifndef __MFRC522_H__
#define __MFRC522_H__
//***************************函数原型******************************************
void InitRc522(void);
char PcdReset(void);
void PcdAntennaOn(void);
void PcdAntennaOff(void);
char PcdRequest(unsigned char req_code, unsigned char *pTagType);
char PcdAnticoll(unsigned char *pSnr);
char PcdSelect(unsigned char *pSnr);
char PcdAuthState(unsigned char auth_mode, unsigned char addr, unsigned char *pKey, unsigned char *pSnr);
char PcdRead(unsigned char addr, unsigned char *pData);
char PcdWrite(unsigned char addr, unsigned char *pData);
char PcdValue(unsigned char dd_mode, unsigned char addr, unsigned char *pValue);
char PcdBakValue(unsigned char sourceaddr, unsigned char goaladdr);
char PcdHalt(void);
char PcdComMF522(unsigned char Command,
                 unsigned char *pInData,
                 unsigned char InLenByte,
                 unsigned char *pOutData,
                 unsigned int  *pOutLenBit);
void CalulateCRC(unsigned char *pIndata, unsigned char len, unsigned char *pOutData);
void WriteRawRC(unsigned char Address, unsigned char value);
unsigned char ReadRawRC(unsigned char Address);
void SetBitMask(unsigned char reg, unsigned char mask);
void ClearBitMask(unsigned char reg, unsigned char mask);

//***************************MF522命令字******************************************
#define PCD_IDLE              0x00               //取消当前命令
#define PCD_AUTHENT           0x0E               //验证秘钥
#define PCD_RECEIVE           0x08               //接收数据
#define PCD_TRANSMIT          0x04               //发送数据
#define PCD_TRANSCEIVE        0x0C               //发送并接收数据
#define PCD_RESETPHASE        0x0F               //复位
#define PCD_CALCCRC           0x03               //CRC计算

//*****************************Mifare_One卡片命令字*********************************
#define PICC_REQIDL           0x26               //寻天线区内未进入休眠状态
#define PICC_REQALL           0x52               //寻天线区内全部卡
#define PICC_ANTICOLL1        0x93               //防冲撞1
#define PICC_ANTICOLL2        0x95               //防冲撞2
#define PICC_AUTHENT1A        0x60               //验证A秘钥
#define PICC_AUTHENT1B        0x61               //验证B秘钥
#define PICC_READ             0x30               //读块
#define PICC_WRITE            0xA0               //写块
#define PICC_DECREMENT        0xC0               //扣款
#define PICC_INCREMENT        0xC1               //充值
#define PICC_RESTORE          0xC2               //调块数据到缓冲区
#define PICC_TRANSFER         0xB0               //保存缓冲区数据
#define PICC_HALT             0x50               //休眠

//****************************MF522 FIFO长度定义***********************************
#define DEF_FIFO_LENGTH       64                 //FIFO size=64byte

//****************************MF522寄存器定义**************************************
// PAGE 0
#define     RFU00                 0x00          //
#define     CommandReg            0x01          //启动和停止命令的执行	    
#define     ComIEnReg             0x02          //中断请求传递的使能和禁能控制位
#define     DivlEnReg             0x03          //中断请求传递的使能和禁能控制位
#define     ComIrqReg             0x04          //包含中断请求标志
#define     DivIrqReg             0x05          //包含中断请求标志
#define     ErrorReg              0x06          //错误标志，指示执行的上个命令的错误状态
#define     Status1Reg            0x07          //包含通信的状态标志  
#define     Status2Reg            0x08          //包含接收器和发送器的状态标志   
#define     FIFODataReg           0x09          //64 字节 FIFO 缓冲区的输入和输出
#define     FIFOLevelReg          0x0A          //指示 FIFO 中存储的字节数
#define     WaterLevelReg         0x0B          //定义 FIFO 下溢和上溢报警的 FIFO 深度
#define     ControlReg            0x0C          //不同的控制寄存器
#define     BitFramingReg         0x0D          //面向位的帧的调节
#define     CollReg               0x0E          //RF 接口上检测到的第一个位冲突的位的位置
#define     RFU0F                 0x0F          //
// PAGE 1
#define     RFU10                 0x10          //
#define     ModeReg               0x11          //定义发送和接收的常用模式
#define     TxModeReg             0x12          //定义发送过程的数据传输速率
#define     RxModeReg             0x13          //定义接收过程中的数据传输速率
#define     TxControlReg          0x14          //控制天线驱动器管脚 TX1 和 TX2 的逻辑特性
#define     TxAutoReg             0x15          //控制天线驱动器的设置
#define     TxSelReg              0x16          //选择天线驱动器的内部源
#define     RxSelReg              0x17          //选择内部的接收器设置
#define     RxThresholdReg        0x18          //选择位译码器的阈值
#define     DemodReg              0x19          //定义解调器的设置
#define     RFU1A                 0x1A          //保留为将来之用
#define     RFU1B                 0x1B          //保留为将来之用
#define     MifareReg             0x1C          //控制 ISO 14443/MIFARE 模式中 106kbit/s 的通信
#define     RFU1D                 0x1D          //保留为将来之用
#define     RFU1E                 0x1E          //保留为将来之用
#define     SerialSpeedReg        0x1F          //选择串行 UART 接口的速率
// PAGE 2
#define     RFU20                 0x20          //  
#define     CRCResultRegM         0x21          //显示 CRC 计算的实际 MSB 和 LSB 值
#define     CRCResultRegL         0x22          //显示 CRC 计算的实际 MSB 和 LSB 值
#define     RFU23                 0x23          //
#define     ModWidthReg           0x24          //控制 ModWidth 的设置
#define     RFU25                 0x25          //
#define     RFCfgReg              0x26          //配置接收器增益
#define     GsNReg                0x27          //选择天线驱动器管脚 TX1 和 TX2 的调制电导
#define     CWGsCfgReg            0x28          //选择天线驱动器管脚 TX1 和 TX2 的调制电导
#define     ModGsCfgReg           0x29          //选择天线驱动器管脚 TX1 和 TX2 的调制电导
#define     TModeReg              0x2A          //定义内部定时器的设置
#define     TPrescalerReg         0x2B          //定义内部定时器的设置
#define     TReloadRegH           0x2C          //描述 16 位长的定时器重装值
#define     TReloadRegL           0x2D          //描述 16 位长的定时器重装值
#define     TCounterValueRegH     0x2E          //显示 16 位长的实际定时器值
#define     TCounterValueRegL     0x2F          //显示 16 位长的实际定时器值
// PAGE 3
#define     RFU30                 0x30          //
#define     TestSel1Reg           0x31          //显示 16 位长的实际定时器值
#define     TestSel2Reg           0x32          //常用测试信号的配置和 PRBS 控制
#define     TestPinEnReg          0x33          //输出驱动器的使能管脚（注：仅用于串行接口）
#define     TestPinValueReg       0x34          //定义 D1-D7 用作 I/O 总线时的值
#define     TestBusReg            0x35          //显示内部测试总线的状态
#define     AutoTestReg           0x36          //控制数字自测试
#define     VersionReg            0x37          //显示版本
#define     AnalogTestReg         0x38          //控制管脚 AUX1 和 AUX2
#define     TestDAC1Reg           0x39          //定义 TestDAC1 的测试值 
#define     TestDAC2Reg           0x3A          //定义 TestDAC1 的测试值 
#define     TestADCReg            0x3B          //显示 ADC I 和 Q 通道的实际值   
#define     RFU3C                 0x3C          //   
#define     RFU3D                 0x3D          //   
#define     RFU3E                 0x3E          //   
#define     RFU3F		          0x3F          //

//和MF522通讯时返回的错误代码
#define MI_OK                          0
#define MI_NOTAGERR                    (-1)
#define MI_ERR                         (-2)

#endif
