84566635/RunnerMachine/(commit log)

2018-04-10 跑步机项目集
    [PCB_Project1.PrjPCB, PCB库.PcbLib, PCB库a.PcbLib, PcbLib-LQFP64.PcbLib, StartV2.PcbDoc, start.PcbDoc, start.SchDoc, 原理图库.SchLib]
2018-10-30 修改整合版本
2018-10-30 修改ReadeMe格式
